Jivyzn/JO7-Vireo/assets/images/README.md

# Image provenance

The images in this directory were extracted from the supplied 2026 JØ7 VIREO research report. The report captions attribute project photographs, screenshots, CAD views and plotted results to **Jivesh Ramnath** unless an upstream tool interface is visible.

| File | Report context |
|---|---|
| `system-architecture.png` | PlantUML system-flow diagram |
| `enclosure-cad.png` | Fusion 360 enclosure modification |
| `odontoid-side.jpg`, `odontoid-top.jpg` | Hand-built voice-controlled camera mechanism |
| `haptic-belt-prototype.jpg` | Belt prototype during testing |
| `model-accuracy-progression.png` | Matplotlib comparison of reported model iterations |
| `pi-system-monitoring.jpg` | Raspberry Pi resource monitoring |
| `vireo-final-enclosure.jpg` | Final enclosure and flexible camera assembly |
| `battery-assembly.jpg` | Prototype reclaimed-cell assembly |
| `hef-conversion.jpg` | Hailo conversion process |

Tool logos, UI elements and third-party software visible inside screenshots remain the property of their respective owners. These images are included for research documentation and project provenance, not to imply endorsement.
