Jivyzn/JO7-Vireo/firmware/prototypes/rp2040_ultrasonic_belt/README.md

# RP2040 ultrasonic belt prototype

This folder preserves the earlier four-zone Arduino Nano RP2040/ultrasonic implementation supplied in the project appendix. It is retained for development history and is **not** the primary belt firmware used by this repository.
