Jivyzn/JO7-Vireo/docs/RELEASE_NOTES_v1.0.2.md

# JØ7 Vireo v1.0.2

This release corrects and standardizes the project's public name as **JØ7 Vireo**.

## Changes

- Replaced the previous display spelling throughout the README and documentation.
- Updated citation and project metadata.
- Renamed the included research report to use **JØ7**.
- Updated branding inside the DOCX research report.
- Updated the GitHub repository description and release titles.
- Preserved ASCII-only technical identifiers required by GitHub and Python packaging.
- Retained the validated Hailo model, firmware, software, tests and documentation.

## Exact spelling

```text
JØ7 Vireo
```

The second character is **Ø** (Unicode U+00D8), not the digit zero.
