Jivyzn/JO7-Vireo/(notices)

Notices in the files:
README.md:
License: AGPL v3
